ubruhin/d0-reader/README.md

# d0-reader

An ethernet interface PCB for electricity smart meters with a D0 infrared
interface, made with [LibrePCB](https://librepcb.org).

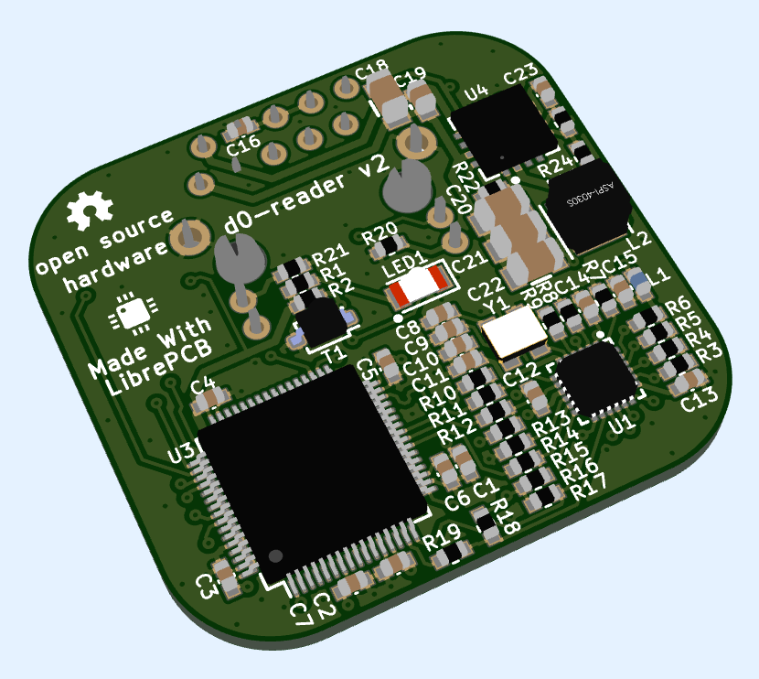
[picture p1: pcb-bottom.png]
PCB Bottom


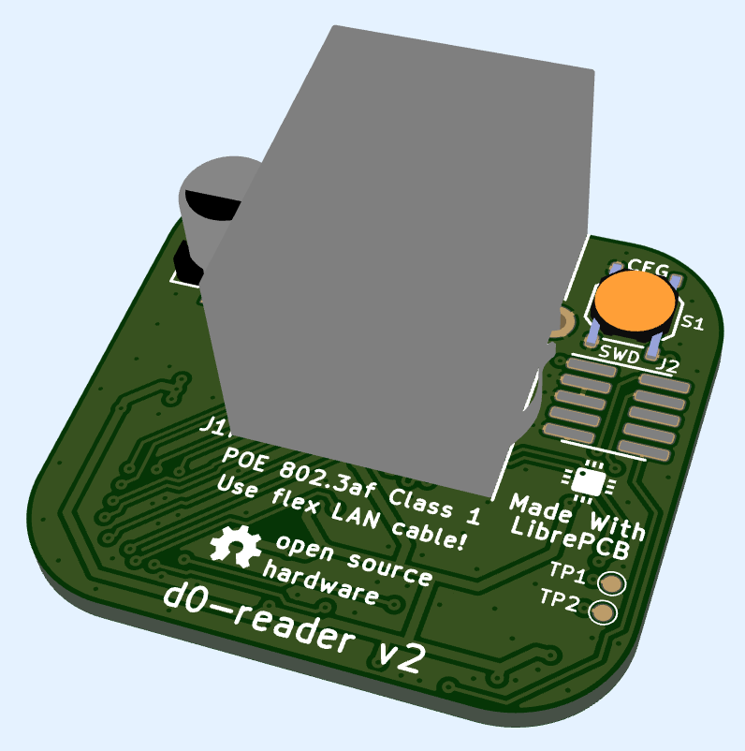
[picture p2: pcb-top.png]
PCB Top
