ubruhin/d0-reader/mechanics/d0-reader-pcb.stl

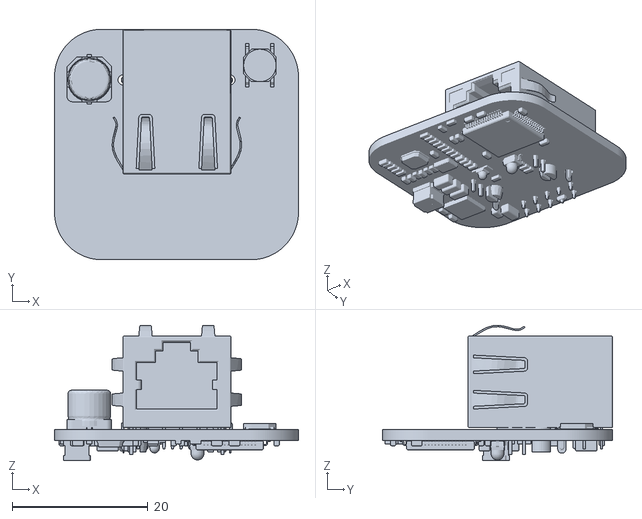
[picture p3: CAD file, 2024-02-21]
mechanics/d0-reader-pcb.stl
36.0 x 34.0 x 20.0
