ubruhin/d0-reader/mechanics/head.stl

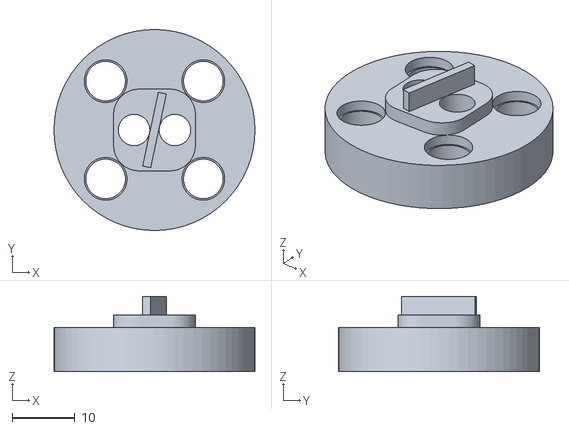
[picture p4: CAD file, 2024-02-21]
mechanics/head.stl
32.0 x 32.0 x 12.0
