ubruhin/d0-reader/mechanics/box.stl

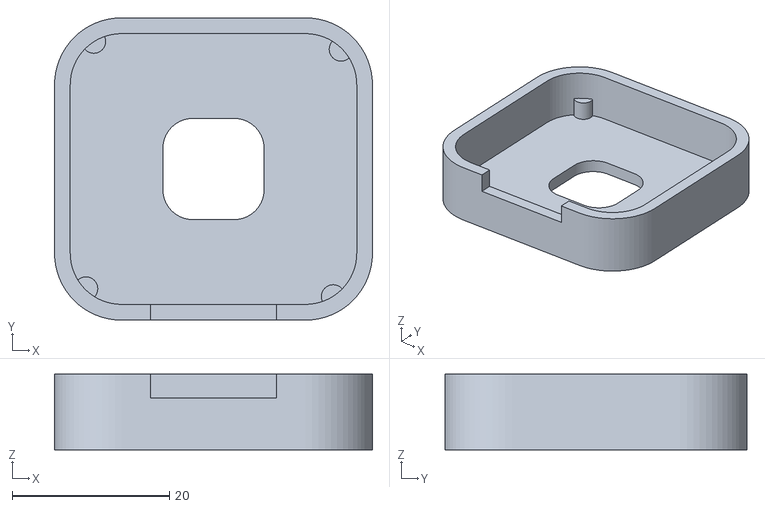
[picture p5: CAD file, 2024-02-21]
mechanics/box.stl
40.4 x 38.4 x 9.60
