ubruhin/d0-reader/mechanics/cover.stl

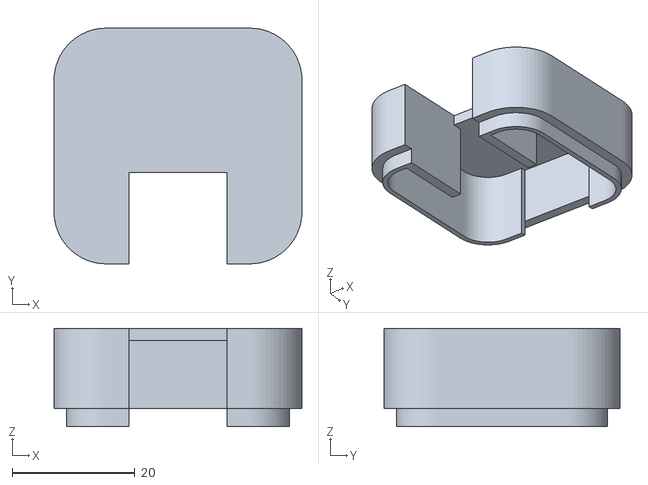
[picture p6: CAD file, 2024-02-21]
mechanics/cover.stl
40.4 x 38.4 x 16.0
