ubruhin/d0-reader/pcb/output/v2/d0-reader_v2_Assembly.pdf

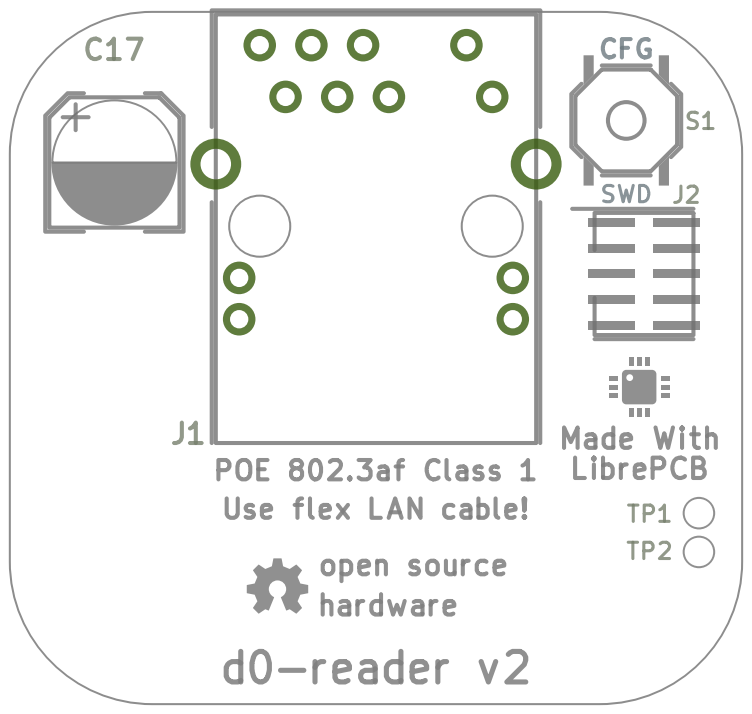
[picture p7: page 1]
Made With

POE 802.3af Class 1
Use flex LAN cable!
open source
hardware
d0-reader v2

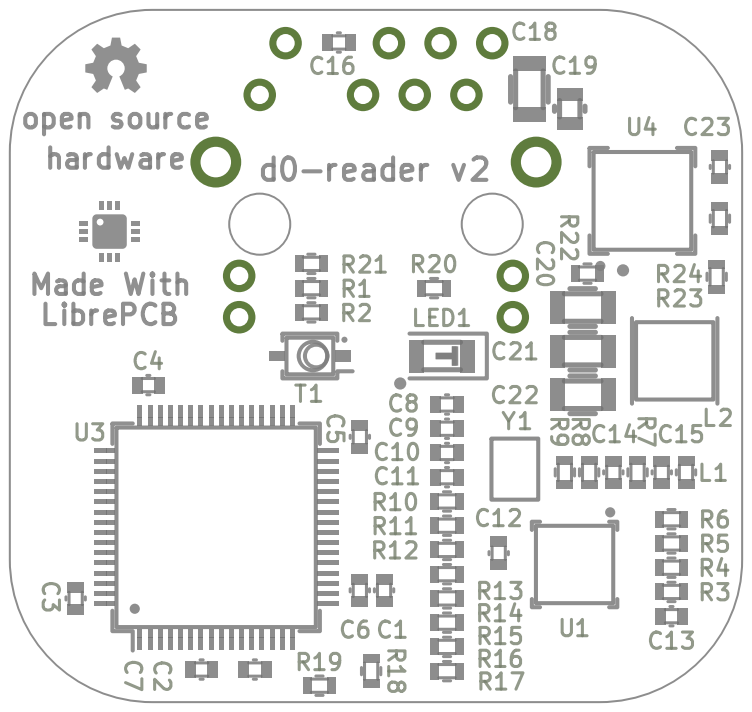
[picture p8: page 2]
