ubruhin/d0-reader/pcb/output/v2/d0-reader_v2_Schematic.pdf

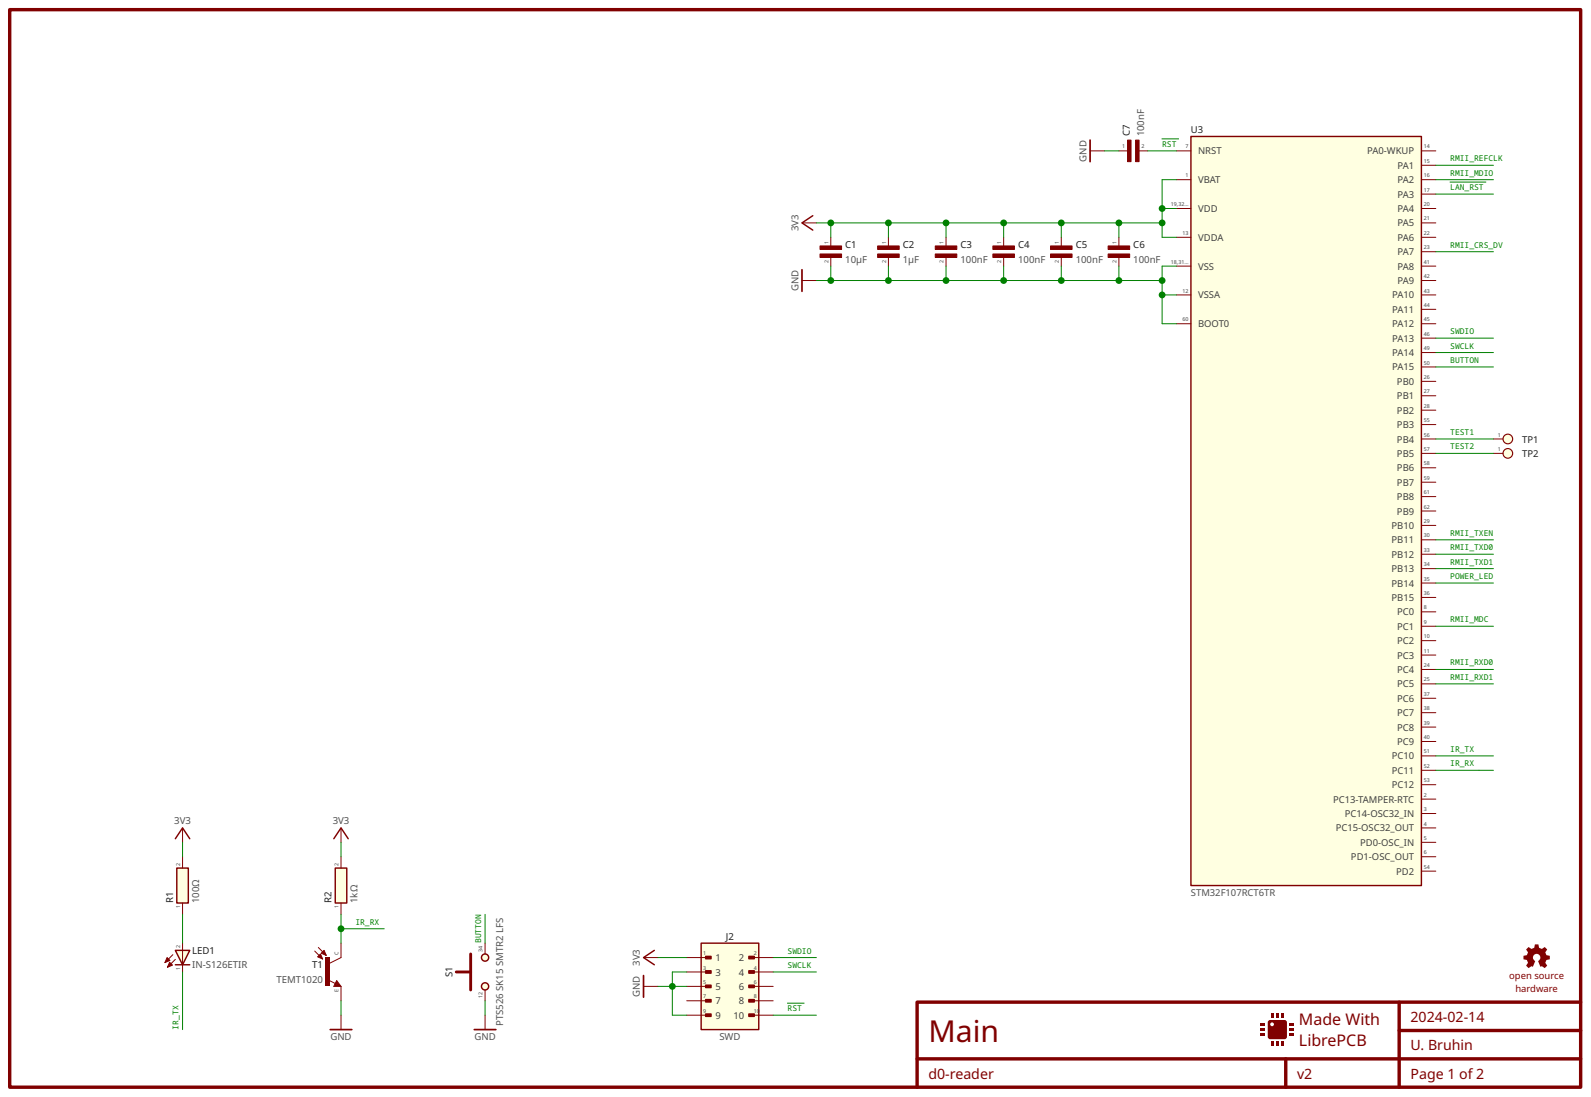
[picture p9: page 1]
hin in; PTS526 SK15 SMTR2 LFS

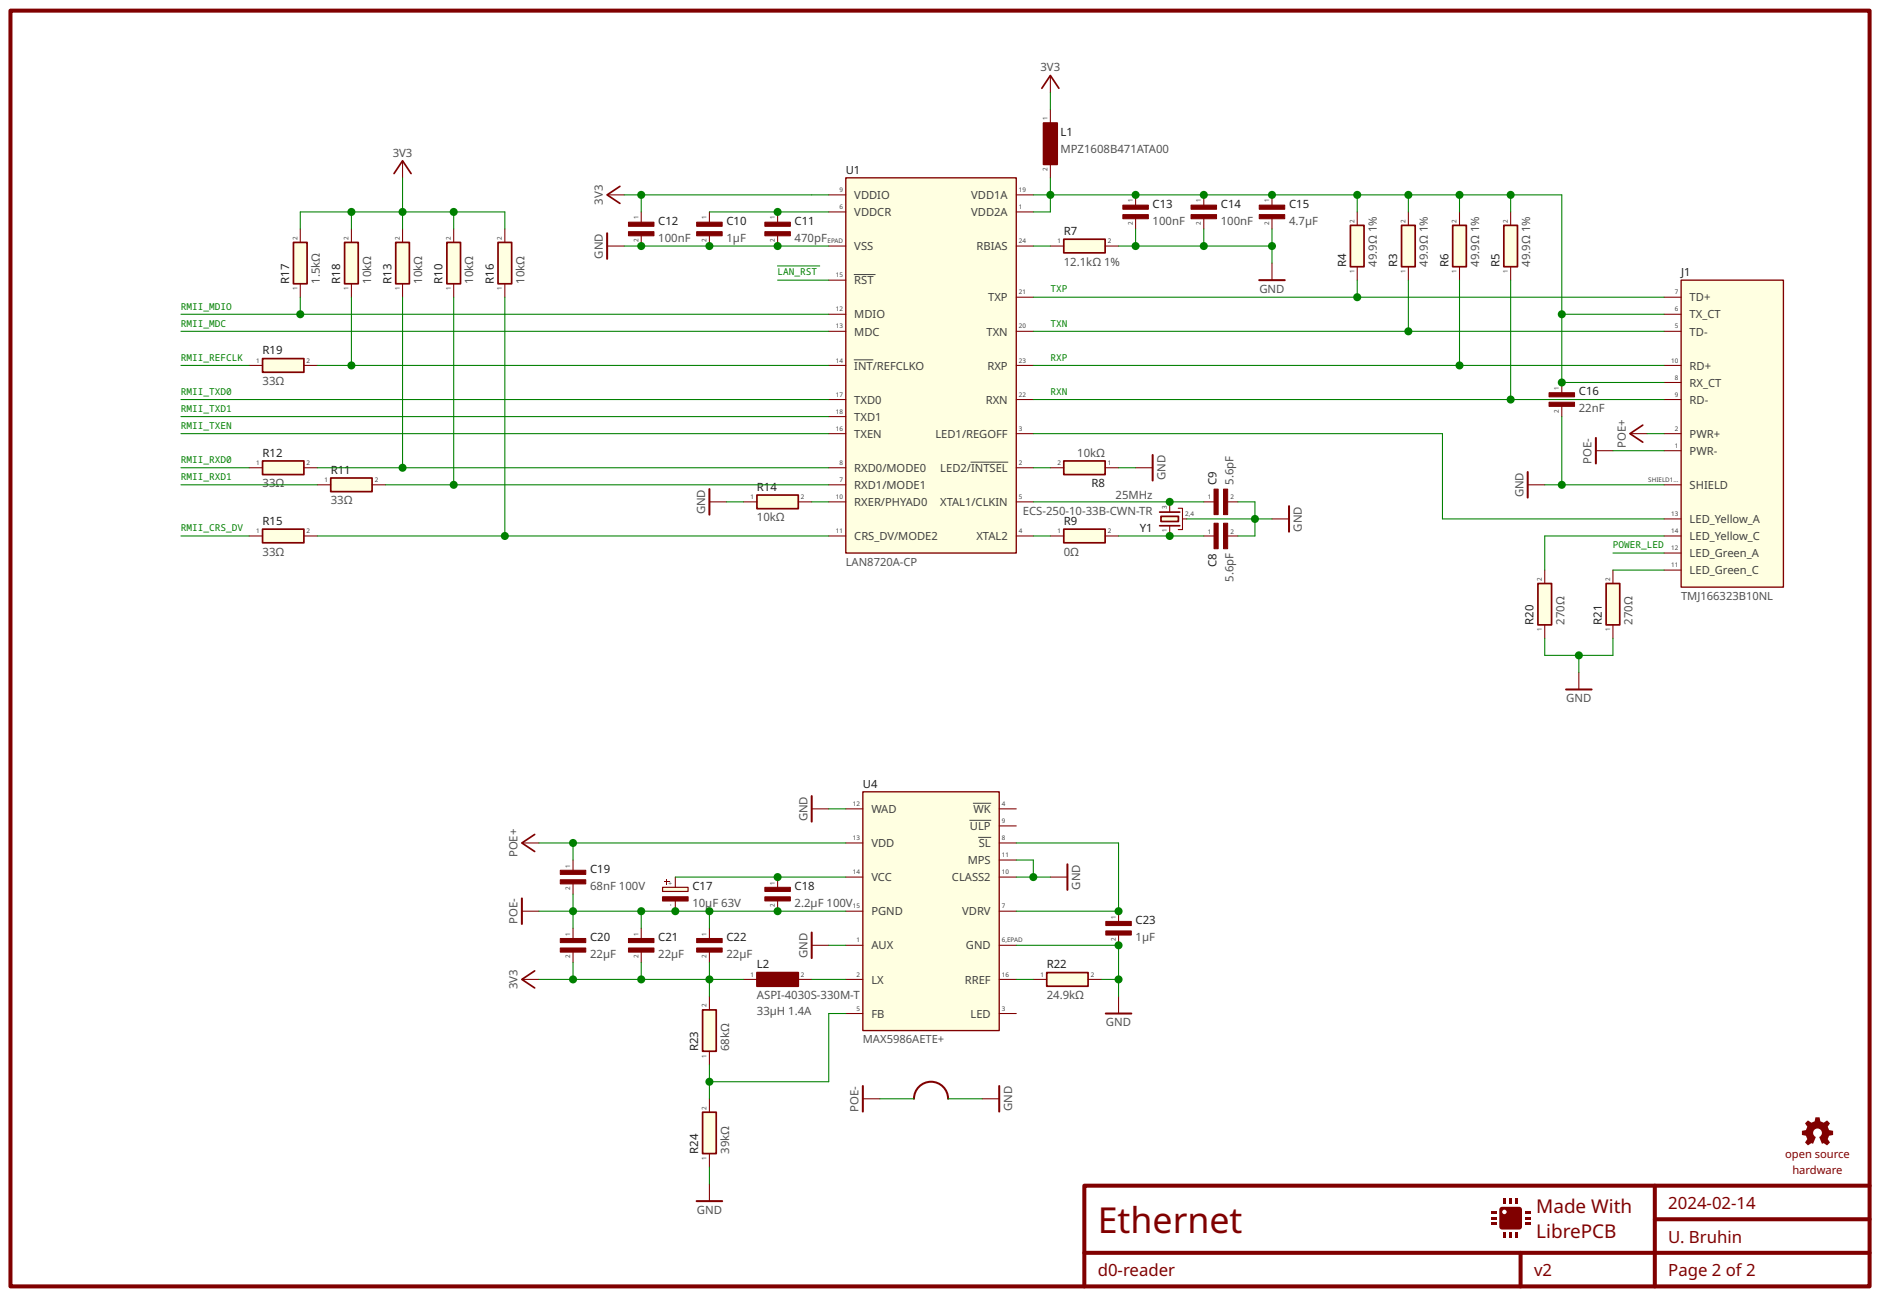
[picture p10: page 2]

RXP 23 | | 10

17 18 16 8 | | 22 RXN | 8
