ubruhin/d0-reader/pcb/output/v1/d0-reader_v1_Schematic.pdf

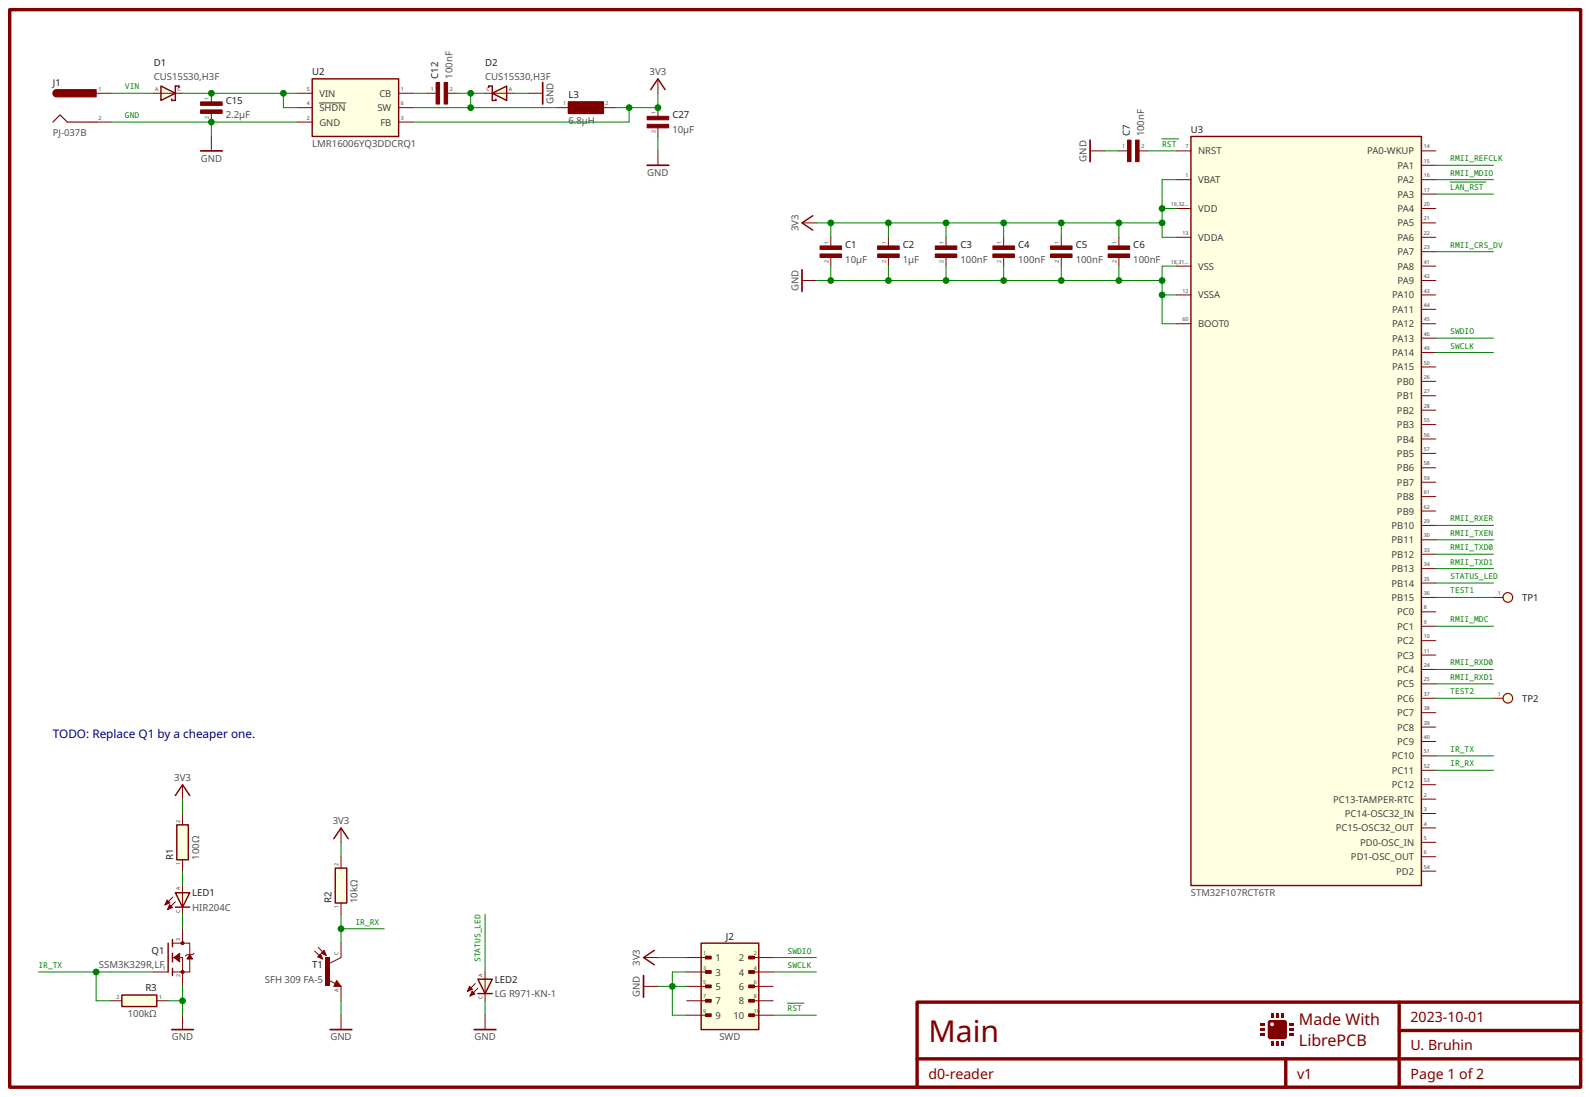
[picture p11: page 1]
hin in

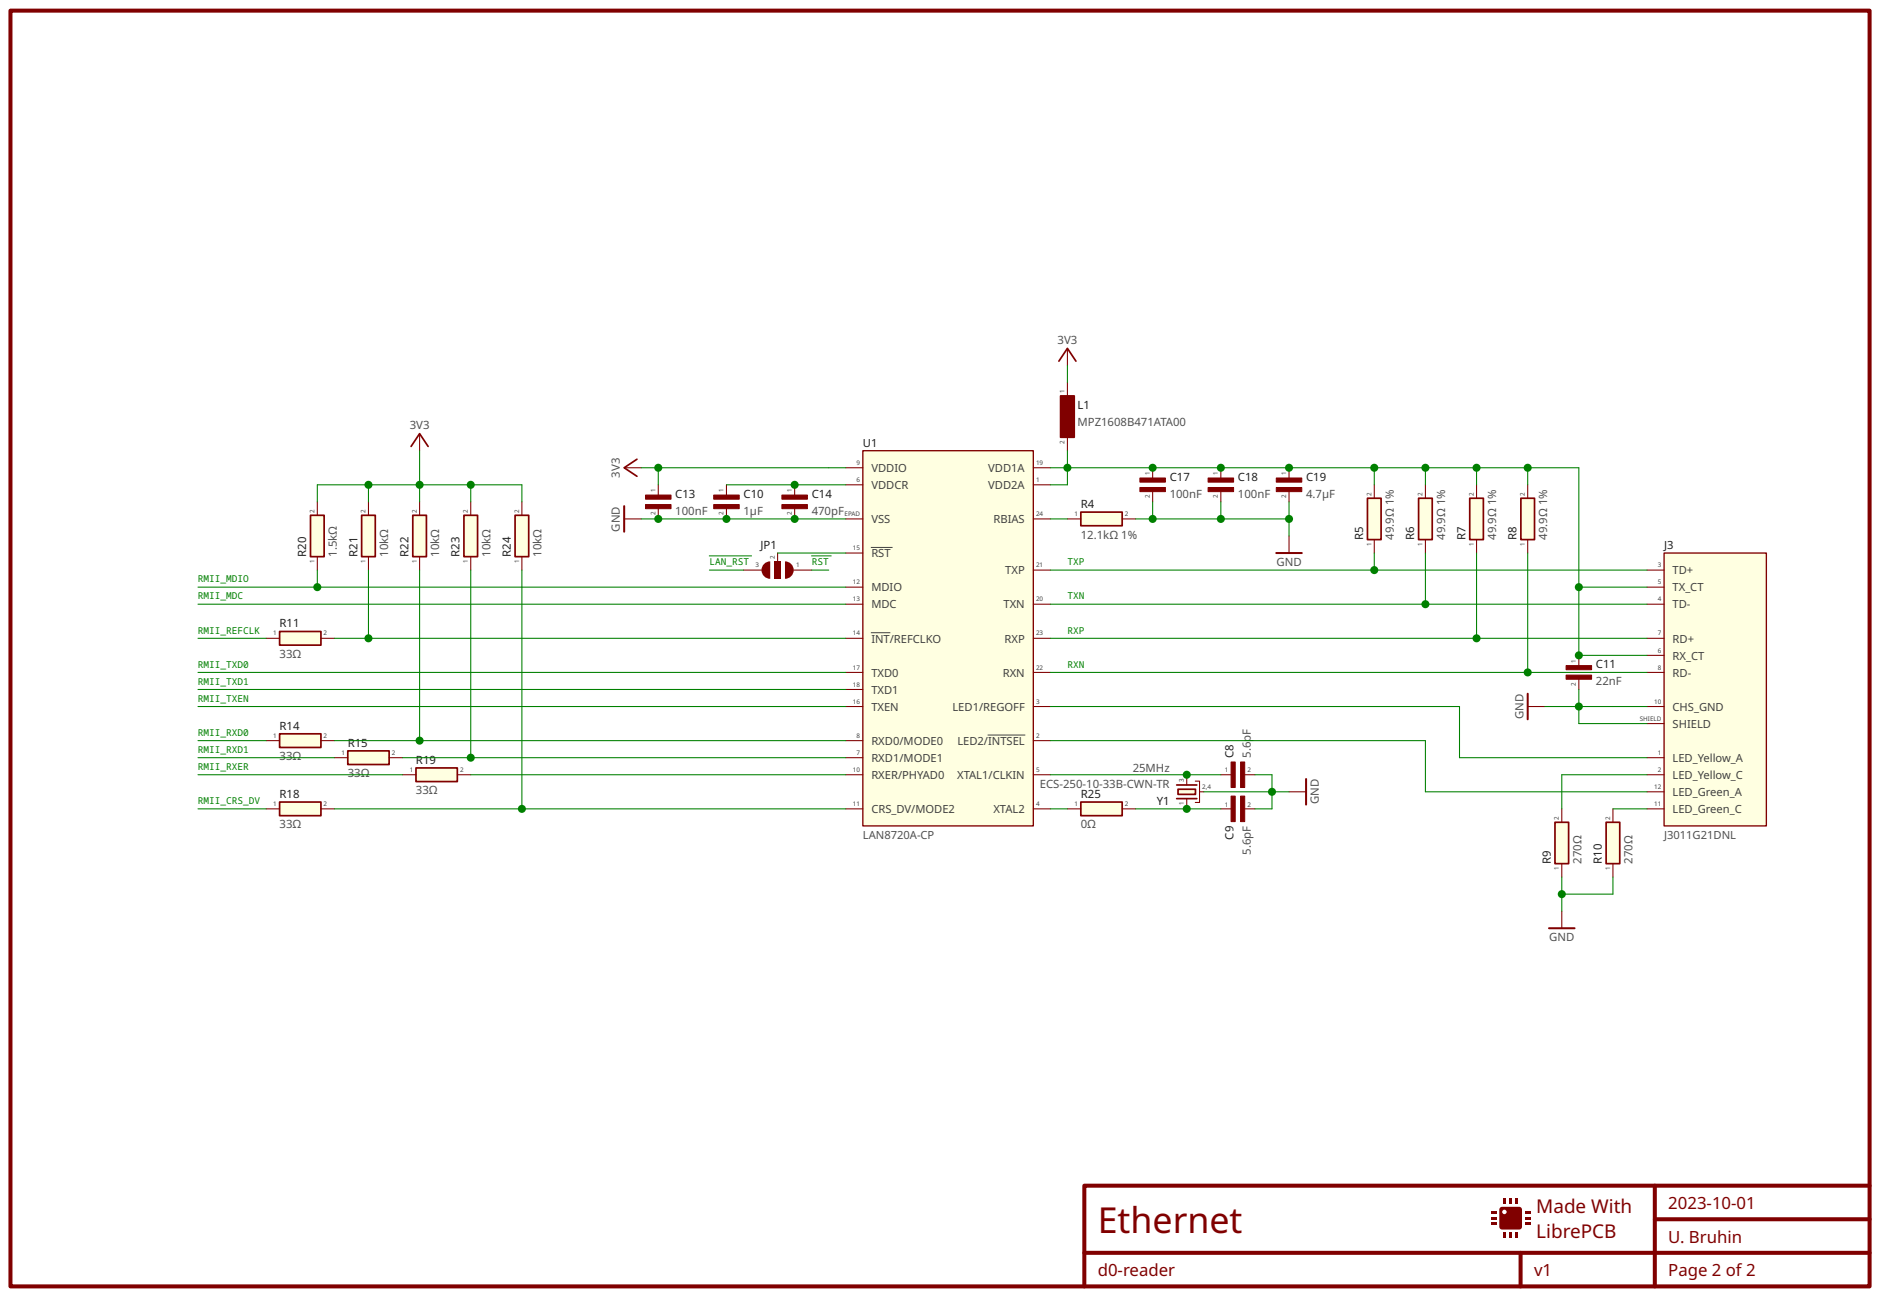
[picture p12: page 2]
