ubruhin/d0-reader/pcb/output/v1/d0-reader_v1_Assembly.pdf

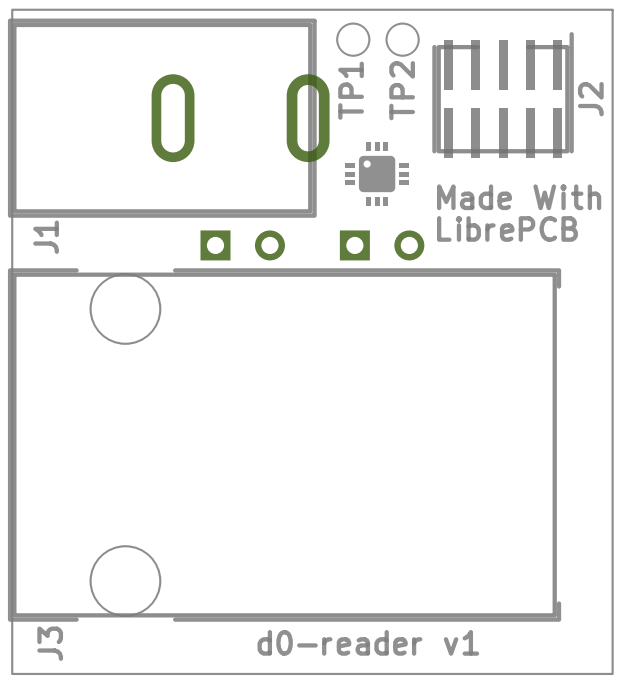
[picture p13: page 1]
Made With; d0-reader v1

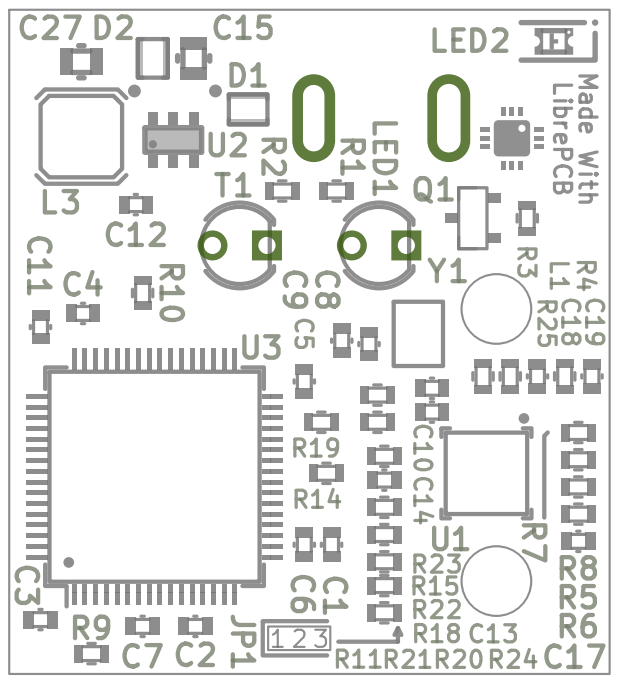
[picture p14: page 2]
