ubruhin/d0-reader/(commit log)

2023-08-26 PCB: Add power supply & STM32F107 to schematic
2023-09-10 PCB: Update project library
2023-09-11 PCB: Add ethernet circuit
2023-09-17 PCB: Finish schematic & layout for v1
2023-09-17 PCB: Release v1
    [d0-reader_v1_BOM_Std.csv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]
2023-10-01 PCB: Replace some MPNs
2023-10-01 PCB: Update output files
    [d0-reader_v1_BOM_Std.csv]
2023-10-01 PCB: Bump version to v2
2023-10-01 PCB: Change C27 to 0603
2023-10-07 PCB: Add BOM as PDF
2023-10-07 PCB: Add missing resistor for LED2 to schematic
2023-10-07 PCB: Add TODOs
2023-12-26 PCB: Add missing pulldown for INTSEL
2023-12-26 PCB: Tie RXER with 10k to GND
2023-12-28 PCB: Fix polarity of IR LED
2023-12-28 PCB: Add a TODO
2023-12-29 Add mechanical design files
    [box.scad, box.stl, cover.scad, cover.stl, head.scad, head.stl]
2023-12-30 Hostware: Print actual power
2023-12-30 PCB: Change phototransistor pull-up to 1k
2023-12-30 Change TCP port & improve error reporting
    [main.rs]
2024-01-01 FW: Switch to fixed 10s update rate
    [main.rs]
2024-02-11 PCB: Complete redesign with POE
2024-02-11 PCB: Release V2
    [d0-reader_v2_BOM_Std.csv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]
2024-02-14 PCB: Fix value of C17: 100uF -> 10uF
    [d0-reader_v2_BOM_Std.csv]
2024-02-17 PCB: Change assembly plan to A4 paper size
2024-02-17 PCB: Add STEP file output job
2024-02-21 PCB: Add comment about design issues
2024-02-21 Update enclosure to new PCB form factor
    [box.scad, box.stl, cover.scad, cover.stl, d0-reader-pcb.stl, head.scad, head.stl]
2024-02-21 FW: Add workaround for ERRORS(1)
    [main.rs]
2024-02-27 PCB: Add item to design issues
2024-03-19 Slightly move around symbols in schematic
